Rohitbels/nodemcu-tank-level/nodeMcuAPIServer/secrets.example.h

// Copy this file to secrets.h (git-ignored) and fill in your Wi-Fi details.
#pragma once

#define WIFI_SSID "your-wifi-name"
#define WIFI_PASSWORD "your-wifi-password"

// Login for the firmware update page at /update
#define OTA_USER "admin"
#define OTA_PASSWORD "choose-a-password"
