Rohitbels/nodemcu-tank-level/(commit log)

2026-10-20 Initial commit: NodeMCU water tank level monitor
    NodeMCU firmware that measures the distance to the water with a
    JSN-SR04T-style sensor only when /api is called, and a phone display
    (docs/tank.js, served by GitHub Pages) that polls it every 3 s, stores
    readings in localStorage and turns red within 25 cm of the sensor.
2026-11-07 Fit the Today tab to the screen without scrolling
    - Top card keeps its height and the tank card takes the rest
    - Scroll only once the tank card reaches its minimum height
    - Enlarge gauge text so it stays readable when the tank is small
    - Add a Hide panel button to the preview
2026-11-07 Blink the LED without Wi-Fi and restart after 5 minutes offline
    The LED stays off on Wi-Fi. Turn on automatic reconnect and restart the
    board if it stays offline, including at startup. Keep the removed sensor
    test page and notes on the loose probe plug in dev/diag.md.
    [nodeMcuAPIServer.ino]
